emadr-03/Progetto-APC/APC_Progetto/Core/Src/main.c

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
/* Includes ------------------------------------------------------------------*/
#include "main.h"

/* USER CODE BEGIN Includes */
#include "lcd.h"      /* driver LCD 4-bit parallelo GPIOD */
#include "as608.h"    /* driver lettore impronta AS608    */
#include <string.h>
#include <stdio.h>
/* USER CODE END Includes */

/* USER CODE BEGIN PTD */
typedef enum {
    S_STANDBY,      /* attesa eventi: TCH (PC5) */
    S_IDENTIFY,     /* scansione impronta con AS608               */
    S_WAIT_ESP,     /* attesa risposta AUTH_RESULT da ESP32       */
    S_RESULT_OK,    /* accesso concesso — LED verde + buzz lungo  */
    S_RESULT_FAIL,  /* accesso negato   — LED rosso + 3 bip       */
    S_ENROLL,       /* registrazione guidata nuova impronta       */
} AppState;
/* USER CODE END PTD */

I2C_HandleTypeDef hi2c1;

SPI_HandleTypeDef hspi1;

UART_HandleTypeDef huart1;
UART_HandleTypeDef huart2;

PCD_HandleTypeDef hpcd_USB_FS;

/* USER CODE BEGIN PV */

static AppState appState = S_STANDBY;

/* ── Flag interrupt ─────────────────────────────────────────────────────────
 * Scritti nelle ISR (HAL_GPIO_EXTI_Callback), letti nel loop principale.
 * Dichiarati volatile per impedire ottimizzazioni del compilatore.         */
static volatile uint8_t flagFinger = 0;   /* PC5 TCH — dito rilevato       */

/* ── UART1 ricezione asincrona (ESP32 → STM32) ─────────────────────────── */
#define RX3_LEN   64
static uint8_t          rx3Byte;               /* buffer singolo byte IT     */
static char             rx3Buf[RX3_LEN];       /* riga accumulata            */
static uint8_t          rx3Idx   = 0;          /* indice di scrittura        */
static volatile uint8_t rx3Ready = 0;          /* flag: riga completa pronta */
static uint32_t         espTimer = 0;          /* timestamp avvio timeout    */

/* ── Ultimo ID identificato ─────────────────────────────────────────────── */
static uint8_t lastFid = 0;

/* ── Macro LED e Buzzer ─────────────────────────────────────────────────── */
#define LED_GREEN   LD7_Pin      /* PE11 — LD7 verde  */
#define LED_RED     LD3_Pin      /* PE9  — LD3 rosso  */
#define LED_PORT    GPIOE
#define BUZ_PIN     GPIO_PIN_8   /* PB8               */
#define BUZ_PORT    GPIOB
#define LOCK_PIN    GPIO_PIN_9   /* PB9 — serratura   */
#define LOCK_PORT   GPIOB        /* HIGH=aperto LOW=chiuso */

/* USER CODE END PV */

void SystemClock_Config(void);
static void MX_GPIO_Init(void);
static void MX_I2C1_Init(void);
static void MX_SPI1_Init(void);
static void MX_USB_PCD_Init(void);
static void MX_USART2_UART_Init(void);
static void MX_USART1_UART_Init(void);
/* USER CODE BEGIN PFP */
static void LED_Set(uint16_t pin, uint8_t on);
static void LED_OffAll(void);
static void Buzz(uint32_t ms);
static void BuzzBoot(void);
static void BuzzOK(void);
static void BuzzFail(void);
static void BuzzConfirm(void);
static void ShowLCD(const char* l1, const char* l2);
static void SendESP(const char* msg);
static void RunEnroll(void);
/* USER CODE END PFP */

/* USER CODE BEGIN 0 */

/* ── Callback EXTI ─────────────────────────────────────────────────────────
 * Gestisce i rising-edge di PC5 (TCH) e PA0 (pulsante).
 * Setta solo il flag — nessuna logica applicativa nell'ISR.                */
void HAL_GPIO_EXTI_Callback(uint16_t GPIO_Pin) {
    if (GPIO_Pin == GPIO_PIN_5) flagFinger = 1;   /* TCH AS608     */
}

/* ── Callback UART1 (ESP32 → STM32) ────────────────────────────────────────
 * Riceve un byte alla volta e assembla la riga fino a '\n'.
 * rx3Ready = 1 segnala che rx3Buf contiene una riga completa.
 * La callback si riarma immediatamente dopo ogni byte.                     */
void HAL_UART_RxCpltCallback(UART_HandleTypeDef* h) {
    if (h->Instance == USART1) {
        char c = (char)rx3Byte;
        if (c == '\n') {
            rx3Buf[rx3Idx] = '\0';
            if (rx3Idx > 0) rx3Ready = 1;
            rx3Idx = 0;
        } else if (c != '\r' && rx3Idx < RX3_LEN - 1) {
            rx3Buf[rx3Idx++] = c;
        }
        HAL_UART_Receive_IT(&huart1, &rx3Byte, 1);
    }
}

/* ── Callback errore UART1 ──────────────────────────────────────────────────
 * Il HAL chiama questa funzione quando USART1 riceve un errore
 * (framing, noise, overrun) — tipicamente causato dal rumore EMI
 * generato dal relè alla commutazione del solenoide.
 * Senza override la catena HAL_UART_Receive_IT si interrompe
 * definitivamente: la STM32 smette di ricevere dall'ESP32 finché
 * non si resetta, causando timeout su tutti i tentativi successivi.
 * Qui si azzera il buffer parziale e si riarma la ricezione.              */
void HAL_UART_ErrorCallback(UART_HandleTypeDef* h) {
    if (h->Instance == USART1) {
        rx3Idx = 0;                                  /* scarta byte corrotti */
        HAL_UART_Receive_IT(h, &rx3Byte, 1);         /* riarma ricezione     */
    }
}

/* ── Primitivi LED e Buzzer ─────────────────────────────────────────────── */

static void LED_Set(uint16_t pin, uint8_t on) {
    HAL_GPIO_WritePin(LED_PORT, pin, on ? GPIO_PIN_SET : GPIO_PIN_RESET);
}
static void LED_OffAll(void) {
    LED_Set(LED_GREEN, 0);
    LED_Set(LED_RED,   0);
}
static void Buzz(uint32_t ms) {
    HAL_GPIO_WritePin(BUZ_PORT, BUZ_PIN, GPIO_PIN_SET);
    HAL_Delay(ms);
    HAL_GPIO_WritePin(BUZ_PORT, BUZ_PIN, GPIO_PIN_RESET);
}

/* Buzzer: Boot=200ms · OK=500ms · Fail=3×100ms · Confirm=80ms */
static void BuzzBoot(void)    { Buzz(200); }
static void BuzzOK(void)      { Buzz(500); }
static void BuzzFail(void)    { Buzz(100); HAL_Delay(80); Buzz(100); HAL_Delay(80); Buzz(100); }
static void BuzzConfirm(void) { Buzz(80);  }

/* ── Serratura ──────────────────────────────────────────────────────────── */
static void Lock_Open(void)  { HAL_GPIO_WritePin(LOCK_PORT, LOCK_PIN, GPIO_PIN_SET);   }
static void Lock_Close(void) { HAL_GPIO_WritePin(LOCK_PORT, LOCK_PIN, GPIO_PIN_RESET); }

/* ── Helper LCD ─────────────────────────────────────────────────────────── */
static void ShowLCD(const char* l1, const char* l2) {
    LCD_Clear();
    LCD_SetCursor(0, 0); LCD_Print(l1);
    LCD_SetCursor(0, 1); LCD_Print(l2);
}

/* ── Helper UART1 (invio verso ESP32) ──────────────────────────────────── */
static void SendESP(const char* msg) {
    char buf[80];
    uint16_t n = (uint16_t)snprintf(buf, sizeof(buf), "%s\r\n", msg);
    HAL_UART_Transmit(&huart1, (uint8_t*)buf, n, 1000);
}

/* ────────────────────────────────────────────────────────────────────────────
 * RunEnroll — procedura guidata di registrazione impronta
 * Cerca il primo slot libero (FindFreeSlot via LoadChar), acquisisce due
 * immagini, genera il modello e lo salva. Parte da slot 1 (ID 0 ignorato).
 * ───────────────────────────────────────────────────────────────────────── */
static void RunEnroll(void) {

    /* ── Cerca il primo slot libero nella libreria AS608 ── */
    ShowLCD("Ricerca slot.. ", "               ");
    int8_t freeSlot = AS608_FindFreeSlot();

    if (freeSlot < 0) {
        ShowLCD("DB Pieno!      ", "Max 127 impr.  ");
        SendESP("ENROLL_RESULT:ERR:DB_FULL");
        BuzzFail();
        HAL_Delay(2000);
        return;
    }

    uint8_t  slot = (uint8_t)freeSlot;
    char     line[17];
    uint32_t t0;

    /* ── Passo 1: prima acquisizione ──────────────────────── */
    ShowLCD("Nuova Impronta ", "Appoggia dito  ");

    t0 = HAL_GetTick();
    while (!AS608_IsFingerPresent()) {
        if (HAL_GetTick() - t0 > 10000) goto enroll_timeout;
        HAL_Delay(100);
    }
    if (AS608_GetImage()               != AS608_OK) goto enroll_error;
    if (AS608_GenChar(AS608_CHARBUF_1) != AS608_OK) goto enroll_error;
    BuzzConfirm();

    /* ── Passo 2: rimozione dito ──────────────────────────── */
    ShowLCD("Togli il dito  ", "               ");
    while (AS608_IsFingerPresent()) HAL_Delay(100);
    HAL_Delay(500);   /* debounce meccanico */

    /* ── Passo 3: seconda acquisizione ───────────────────── */
    ShowLCD("Appoggia        ", "di nuovo       ");

    t0 = HAL_GetTick();
    while (!AS608_IsFingerPresent()) {
        if (HAL_GetTick() - t0 > 10000) goto enroll_timeout;
        HAL_Delay(100);
    }
    if (AS608_GetImage()               != AS608_OK) goto enroll_error;
    if (AS608_GenChar(AS608_CHARBUF_2) != AS608_OK) goto enroll_error;
    BuzzConfirm();

    /* ── Passo 4: genera modello e salva ─────────────────── */
    if (AS608_RegModel()      != AS608_OK) goto enroll_error;
    if (AS608_StoreChar(slot) != AS608_OK) goto enroll_error;

    /* ── Successo ─────────────────────────────────────────── */
    snprintf(line, sizeof(line), "Salvata ID: %u", (unsigned)slot);
    ShowLCD("Impronta OK!   ", line);
    {
        char msg[32];
        snprintf(msg, sizeof(msg), "ENROLL_RESULT:%u:OK", (unsigned)slot);
        SendESP(msg);
    }
    BuzzOK();
    HAL_Delay(2000);
    return;

enroll_error:
    ShowLCD("Errore Registr.", "               ");
    SendESP("ENROLL_RESULT:ERR:FAIL");
    BuzzFail();
    HAL_Delay(2000);
    return;

enroll_timeout:
    ShowLCD("Timeout        ", "Operaz. annull.");
    SendESP("ENROLL_RESULT:ERR:TIMEOUT");
    BuzzFail();
    HAL_Delay(2000);
}

/* USER CODE END 0 */

/**
  * @brief  The application entry point.
  * @retval int
  */
int main(void)
{

  /* MCU Configuration--------------------------------------------------------*/

  /* Reset of all peripherals, Initializes the Flash interface and the Systick. */
  HAL_Init();

  /* Configure the system clock */
  SystemClock_Config();

  /* Initialize all configured peripherals */
  MX_GPIO_Init();
  MX_I2C1_Init();
  MX_SPI1_Init();
  MX_USB_PCD_Init();
  MX_USART2_UART_Init();
  MX_USART1_UART_Init();
  /* USER CODE BEGIN 2 */

  LCD_Init();
  AS608_Init(&huart2);

  /* ══════════════════════════════════════════════════════
   * SEQUENZA DI BOOT
   * ══════════════════════════════════════════════════════ */

  /* 1. Controllo reset hardware ─────────────────────────
   * Legge PA0 direttamente dopo MX_GPIO_Init().
   * Se il pulsante è tenuto premuto all'accensione, azzera
   * l'intera libreria biometrica dell'AS608.
   *
   * Strategia doppia:
   *   a) Prova EmptyDB (comando bulk rapido)
   *   b) Se LoadChar su slot 0 o 1 risponde ancora OK,
   *      EmptyDB non ha funzionato → cancella slot 0-127
   *      uno per uno con DeleteChar (fallback sicuro).    */
  if (HAL_GPIO_ReadPin(GPIOA, GPIO_PIN_0) == GPIO_PIN_SET) {

      HAL_Delay(200);
      ShowLCD("Reset Database ", "In corso...    ");

      /* Handshake obbligatorio prima di qualsiasi comando */
      if (AS608_VerifyPassword() != AS608_OK) {
          ShowLCD("Errore Sensore ", "Reset annullato");
          BuzzFail();
          HAL_Delay(2000);
          goto boot_continue;
      }

      /* Tentativo 1: EmptyDB bulk */
      AS608_EmptyDB();
      HAL_Delay(1500);

      /* Verifica effettiva: slot 0 e slot 1 devono essere vuoti */
      uint8_t slot0_occupied = (AS608_LoadChar(AS608_CHARBUF_2, 0) == AS608_OK);
      uint8_t slot1_occupied = (AS608_LoadChar(AS608_CHARBUF_2, 1) == AS608_OK);

      if (slot0_occupied || slot1_occupied) {
          /* EmptyDB non ha funzionato — fallback: DeleteChar slot per slot */
          ShowLCD("Pulizia manuale", "Attendere...   ");
          uint8_t errCount = 0;
          for (uint8_t i = 0; i <= 127; i++) {
              /* Cancella solo se lo slot è occupato */
              if (AS608_LoadChar(AS608_CHARBUF_2, i) == AS608_OK) {
                  if (AS608_DeleteChar(i) != AS608_OK) errCount++;
              }
              HAL_Delay(50);
          }

          /* Verifica finale dopo cancellazione manuale */
          if (AS608_LoadChar(AS608_CHARBUF_2, 1) != AS608_OK) {
              ShowLCD("Database       ", "Azzerato!      ");
              SendESP("DB_RESET");
              Buzz(500);
          } else {
              ShowLCD("Errore Reset   ", "Riprovare      ");
              BuzzFail();
          }
      } else {
          /* EmptyDB ha funzionato */
          ShowLCD("Database       ", "Azzerato!      ");
          SendESP("DB_RESET");
          Buzz(500);
      }

      HAL_Delay(2000);
  }

/* Destinazione goto: salta il reset hardware se AS608_VerifyPassword() fallisce */
boot_continue:

  /* 2. Splash screen ──────────────────────────────────── */
  ShowLCD("   Magic Box   ", " Progetto APC  ");
  BuzzBoot();
  HAL_Delay(1500);

  /* 3. Self-test sensore ────────────────────────────────
   * Handshake obbligatorio con l'AS608 tramite VFY_PWD.
   * In caso di fallimento il sistema si blocca: senza
   * sensore funzionante non ha senso proseguire.         */
  ShowLCD("Init sensore...", "               ");
  if (AS608_VerifyPassword() != AS608_OK) {
      ShowLCD("Errore Sensore ", "Sistema fermo  ");
      BuzzFail();
      while (1);   /* halt bloccante */
  }

  /* 4. Avvio ricezione asincrona ESP32 + notifica boot ── */
  HAL_UART_Receive_IT(&huart1, &rx3Byte, 1);
  SendESP("BOOT:SYSTEM_OK");

  appState = S_STANDBY;

  /* USER CODE END 2 */

  /* Infinite loop */
  /* USER CODE BEGIN WHILE */
  while (1)
  {
    switch (appState) {

    /* ── S_STANDBY ─────────────────────────────────────────
     * Stato di riposo. Rimane in spin-wait finché arriva un
     * dito (PC5) o un comando ESP32 via UART (ENROLL_START,
     * DELETE_CHAR:<id>, AS608_RESET).                        */
    case S_STANDBY:
        ShowLCD("   Magic Box   ", "Attesa impronta");
        LED_OffAll();
        flagFinger = 0;
        while (!flagFinger && !rx3Ready) HAL_Delay(50);

        if (rx3Ready) {
            if (strcmp(rx3Buf, "ENROLL_START") == 0) {
                appState = S_ENROLL;
            } else if (strncmp(rx3Buf, "DELETE_CHAR:", 12) == 0) {
                uint8_t delId = (uint8_t)atoi(rx3Buf + 12);
                char resp[32];
                uint8_t attempts = 0;
                uint8_t deleted  = 0;
                while (attempts < 3 && !deleted) {
                    AS608_DeleteChar(delId);
                    HAL_Delay(300);
                    /* LoadChar OK → slot ancora occupato; errore → slot libero */
                    if (AS608_LoadChar(AS608_CHARBUF_2, delId) != AS608_OK) {
                        deleted = 1;
                    } else if (attempts < 2) {
                        HAL_Delay(200);
                    }
                    attempts++;
                }
                snprintf(resp, sizeof(resp),
                         deleted ? "DELETE_CHAR_OK:%u" : "DELETE_CHAR_ERR:%u",
                         (unsigned)delId);
                SendESP(resp);
                appState = S_STANDBY;
            } else if (strcmp(rx3Buf, "AS608_RESET") == 0) {
                ShowLCD("Reset DB...    ", "In corso...    ");
                if (AS608_VerifyPassword() != AS608_OK) {
                    ShowLCD("Errore Sensore ", "Reset annullato");
                    SendESP("AS608_RESET_ERR");
                    BuzzFail();
                    HAL_Delay(1500);
                    appState = S_STANDBY;
                    break;
                }

                /* Tentativo 1: EmptyDB bulk */
                AS608_EmptyDB();
                HAL_Delay(1500);

                /* Verifica effettiva: slot 0 e slot 1 devono essere vuoti */
                uint8_t r0 = (AS608_LoadChar(AS608_CHARBUF_2, 0) == AS608_OK);
                uint8_t r1 = (AS608_LoadChar(AS608_CHARBUF_2, 1) == AS608_OK);

                if (r0 || r1) {
                    /* EmptyDB non ha funzionato — fallback: DeleteChar slot per slot */
                    ShowLCD("Pulizia manuale", "Attendere...   ");
                    for (uint8_t i = 0; i <= 127; i++) {
                        if (AS608_LoadChar(AS608_CHARBUF_2, i) == AS608_OK) {
                            AS608_DeleteChar(i);
                        }
                        HAL_Delay(50);
                    }
                }

                /* Verifica finale */
                if (AS608_LoadChar(AS608_CHARBUF_2, 1) != AS608_OK) {
                    ShowLCD("Database       ", "Azzerato!      ");
                    SendESP("AS608_RESET_OK");
                    Buzz(500);
                } else {
                    ShowLCD("Errore Reset   ", "Riprovare      ");
                    SendESP("AS608_RESET_ERR");
                    BuzzFail();
                }
                HAL_Delay(1500);
                appState = S_STANDBY;
            } else {
                appState = S_STANDBY;
            }
            rx3Ready = 0;
        } else {
            flagFinger = 0;
            appState   = S_IDENTIFY;
        }
        break;

    /* ── S_IDENTIFY ────────────────────────────────────────
     * Chiede all'AS608 di scansionare e cercare il dito nella
     * sua libreria flash (ricerca 1:N autonoma).
     * Se trovato, invia l'ID all'ESP32 per la verifica nel
     * database relazionale (nome, ruolo, permessi).
     *
     * CRITICO: rx3Ready e rx3Idx vengono azzerati PRIMA di
     * SendESP — se la risposta arriva durante ShowLCD (che
     * chiama HAL_Delay internamente), l'ISR setta rx3Ready=1
     * e il dato rimane valido. Azzerarlo dopo SendESP lo
     * cancellerebbe silenziosamente (race condition).        */
    case S_IDENTIFY: {
        ShowLCD("  Scansione... ", "               ");

        uint8_t  fid   = 0;
        uint16_t score = 0;
        AS608_Result r = AS608_IdentifyFinger(&fid, &score);

        if (r == AS608_OK) {
            lastFid = fid;
            char req[32];
            snprintf(req, sizeof(req), "AUTH_REQUEST:%d", fid);

            ShowLCD("Verifica...    ", "               ");

            /* Pulisci buffer PRIMA di inviare la richiesta */
            rx3Ready = 0;
            rx3Idx   = 0;

            SendESP(req);
            espTimer = HAL_GetTick();
            appState = S_WAIT_ESP;
        } else if (r == AS608_ERR_TIMEOUT) {
            /* AS608 non risponde alla UART */
            SendESP("ERR:AS608_TIMEOUT");
            appState = S_RESULT_FAIL;
        } else {
            /* no-match (0x09), immagine sfocata (0x03), ecc. */
            SendESP("ALERT:UNKNOWN_FINGER");
            appState = S_RESULT_FAIL;
        }
        break;
    }

    /* ── S_WAIT_ESP ────────────────────────────────────────
     * Attende la risposta dell'ESP32 entro 10 secondi.
     * Messaggio atteso: "AUTH_RESULT:<id>:GRANTED|DENIED"
     *
     * IMPORTANTE: il timeout è else-if — se rx3Ready è già
     * true nel medesimo ciclo il timeout non sovrascrive
     * il risultato (race condition fix).                   */
    case S_WAIT_ESP:
        if (rx3Ready) {
            rx3Ready = 0;
            if (strncmp(rx3Buf, "AUTH_RESULT:", 12) == 0) {
                appState = strstr(rx3Buf, "GRANTED") ? S_RESULT_OK : S_RESULT_FAIL;
            }
        } else if (HAL_GetTick() - espTimer > 1500) {
            SendESP("ERR:ESP32_TIMEOUT");
            appState = S_RESULT_FAIL;
        }
        else{
        	HAL_Delay(50);
        }
        break;

    /* ── S_RESULT_OK ───────────────────────────────────────
     * Accesso concesso. LED verde fisso per 2 s + bip lungo.
     * PB9 → HIGH (serratura aperta) per 2 s, poi LOW (chiusa). */
    case S_RESULT_OK: {
        char line2[17];
        snprintf(line2, sizeof(line2), "ID: %u", (unsigned)lastFid);
        ShowLCD("Accesso OK!    ", line2);
        LED_Set(LED_GREEN, 1);
        BuzzOK();
        Lock_Open();            /* PB9 HIGH — serratura aperta  */
        HAL_Delay(1000);
        Lock_Close();           /* PB9 LOW  — serratura chiusa  */
        LED_OffAll();
        appState = S_STANDBY;
        break;
    }

    /* ── S_RESULT_FAIL ─────────────────────────────────────
     * Accesso negato. LED rosso fisso per 2 s + 3 bip rapidi. */
    case S_RESULT_FAIL:
        ShowLCD("Accesso Negato ", "               ");
        LED_Set(LED_RED, 1);
        BuzzFail();
        HAL_Delay(1500);
        LED_OffAll();
        appState = S_STANDBY;
        break;

    /* ── S_ENROLL ──────────────────────────────────────────
     * Registrazione guidata di una nuova impronta.
     * La logica è in RunEnroll() per mantenere il switch
     * leggibile. Dopo il ritorno torna sempre a S_STANDBY. */
    case S_ENROLL:
        RunEnroll();
        appState = S_STANDBY;
        break;

    } /* end switch */

    /* USER CODE END WHILE */

    /* USER CODE BEGIN 3 */
  }
  /* USER CODE END 3 */
}

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
