emadr-03/Progetto-APC/(commit log)

2026-05-20 Added ESP32 file
2026-05-20 rinomina del progetto
    cambio di nome del progetto
2026-05-25 Fix db registrazione impronta
    [progetto_APC_ESP32.ino]
2026-05-27 Fix DB reset sync, PA0 GPIO init e race condition in STANDBY/IDENTIFY
    - Aggiunge SendESP("DB_RESET") in entrambi i path del reset DB (EmptyDB e
    fallback DeleteChar), così l'ESP32 viene notificato e cancella il suo
    SQLite in entrambi i casi
    - Aggiunge init GPIO per PA0 come IT_RISING (era assente da MX_GPIO_Init)
    e lo registra nel file .ioc
    - Sposta ShowLCD("Verifica...") PRIMA del clear di rx3Ready/rx3Idx in
    S_IDENTIFY, eliminando la race condition in cui la risposta ESP32 poteva
    arrivare mentre il buffer era già azzerato
    - Corregge l'ordine di rx3Ready = 0 in S_STANDBY per evitare che il flag
    venga cancellato prima del confronto strcmp
    - Aggiorna commento timeout S_WAIT_ESP da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
    [APC_Progetto.ioc, main.c]
2026-05-27 Rimuovi APC_Progetto/Debug dal tracking git
    I file di build (elf, map, list, .o, .su, .d, makefile ecc.) erano
    tracciati per errore nonostante il gitignore li escludesse.
    git rm --cached li rimuove dall'indice senza cancellarli dal disco.
2026-05-27 Migra ESP32 UART da USART3 (PB10/PB11) a USART1 (PA9/PA10)
    Sposta i cavi UART dell'ESP32 sul connettore Port-A per separare
    fisicamente le linee dati dai cavi di alimentazione 12V della
    serratura, riducendo l'interferenza EMI che causava timeout casuali
    dopo l'apertura. Aggiornati main.c (ErrorCallback, SendESP, boot,
    header), .ioc CubeMX e commenti ESP32 .ino.
    [APC_Progetto.ioc, main.c, progetto_APC_ESP32.ino]
2026-05-27 Fix timeout EMI: filtro byte non-ASCII ESP32 + timeout 1500ms STM32
    ESP32: i byte spuri generati dal back-EMF del solenoide si accumulano
    in rxBuf e corrompono il parsing di AUTH_REQUEST (strncmp fallisce).
    Il filtro ASCII azzera il buffer parziale ad ogni byte non valido,
    garantendo che ogni comando parta sempre da posizione 0.
    STM32: ridotto il timeout S_WAIT_ESP da 3000 a 1500 ms — la risposta
    normale e' quasi istantanea, un timeout piu' basso riduce la latenza
    percepita in caso di errore.
    [main.c, progetto_APC_ESP32.ino]
2026-05-27 Fix ESP32 UART: scarta riga intera su byte non-ASCII (rxDiscard flag)
    Azzerare solo rxIdx non bastava: i byte successivi al byte spurio
    venivano accumulati e processati come riga parziale (es. byte spurio
    in mezzo ad AUTH_REQUEST produceva handle("TH_REQUEST:1") -> nessun
    match -> timeout). Il flag rxDiscard ignora tutti i byte fino al
    prossimo '\n', garantendo che handle() riceva solo righe integre.
    [progetto_APC_ESP32.ino]
2026-05-27 Modificata durata di apertura serratura
    La durata dell'attivazione della serratura é stata diminuita da 2 s a 1s. 1s é piu che sufficiente
2026-05-27 Redesign dashboard web: stats, utenti, log colorato, step enrollment, gestione utenti
    - Ridisegno completo UI con stats row, griglia a due colonne e log eventi colorato
    - Lista utenti con toggle accesso rapido e modal modifica (nome, ruolo, accesso)
    - Endpoint Flask GET/PATCH /api/users come proxy verso ESP32
    - ESP32: aggiunto GET /api/users e PATCH /api/users (SQLite), fix rxDiscard per UART
    [progetto_APC_ESP32.ino]
2026-05-27 Aggiungi reset database via interfaccia web
    - Bottone "Azzera DB" nella sezione utenti con dialog di conferma
    - ESP32: endpoint POST /api/reset — invia AS608_RESET alla STM32 via UART,
    attende risposta (max 10 s), azzera SQLite solo se AS608 conferma OK
    - STM32: gestione comando AS608_RESET in S_STANDBY — EmptyDB + risposta UART
    - Flask: proxy POST /api/reset con timeout 15 s
    - UI: alert distinto per successo completo vs sensore non raggiungibile
    [main.c, progetto_APC_ESP32.ino]
2026-05-27 Aggiungi eliminazione singolo utente e fix reset database
    - Fix resetUserDatabase: usa DELETE SQL invece di LittleFS.remove (percorso errato)
    - Eliminazione utente: bottone cestino per riga, conferma dialog
    - ESP32: DELETE /api/users — invia DELETE_CHAR:<id> alla STM32, attende ok (max 5s)
    - STM32: gestione DELETE_CHAR:<id> con retry (3 tentativi) e verifica LoadChar
    - Flask: proxy DELETE /api/users con timeout 8s
    [main.c, progetto_APC_ESP32.ino]
2026-05-27 Pulizia codice: rimozione dead code e aggiornamento commenti
    main.c:
    - Rimosso //flagFinger = 0 duplicato in S_STANDBY
    - Rimosso //rx3Ready = 0 commentato in S_STANDBY
    - Rimosso blocco else commentato in S_WAIT_ESP
    - Aggiornato commento S_STANDBY con i comandi UART ora gestiti
    - Aggiornato commento boot_continue label
    - Semplificati commenti RunEnroll e pattern buzzer
    progetto_APC_ESP32.ino:
    - Rimossa funzione setAccess() non utilizzata
    - Rimosso #define SEED_DEFAULT_USERS e relativo blocco #if (mai compilato)
    [main.c, progetto_APC_ESP32.ino]
2026-05-27 Fix resetUserDatabase: controlla return code sqlite3_exec
    - resetUserDatabase() ora ritorna bool e logga errore se DELETE fallisce
    - Enrollment state e evento db_reset vengono aggiornati solo su successo
    - handleApiReset: gestisce i 3 casi (AS608 err / DB err / successo completo)
    - app.js: alert distinto per stato parziale (AS608 ok ma DB fallito)
    [progetto_APC_ESP32.ino]
2026-05-27 Fix handleApiUserDelete: separa bad_json da missing_id
    [progetto_APC_ESP32.ino]
2026-05-27 STM32: verifica effettiva svuotamento AS608 in AS608_RESET handler
    AS608_EmptyDB() non garantisce lo svuotamento: ora si verifica con
    LoadChar sugli slot 0 e 1 dopo il comando bulk, e in caso di fallimento
    si esegue un DeleteChar slot-per-slot (0-127) come fallback.
    AS608_RESET_OK viene inviato solo se la verifica finale conferma
    che lo slot 1 è effettivamente libero.
