emadr-03/Progetto-APC/(notices)

Notices in the files:
APC_Progetto/Core/Src/main.c:
Copyright (c) 2026 STMicroelectronics. All rights reserved.
This software is licensed under terms found in the LICENSE file.
APC_Progetto/Core/Inc/main.h:
Copyright (c) 2026 STMicroelectronics.
All rights reserved.
This software is licensed under terms that can be found in the LICENSE file
